rallekralle11/Genna/README.md

# Genna

Work in progress. I believe i can get it working but i won't deal with that right now.

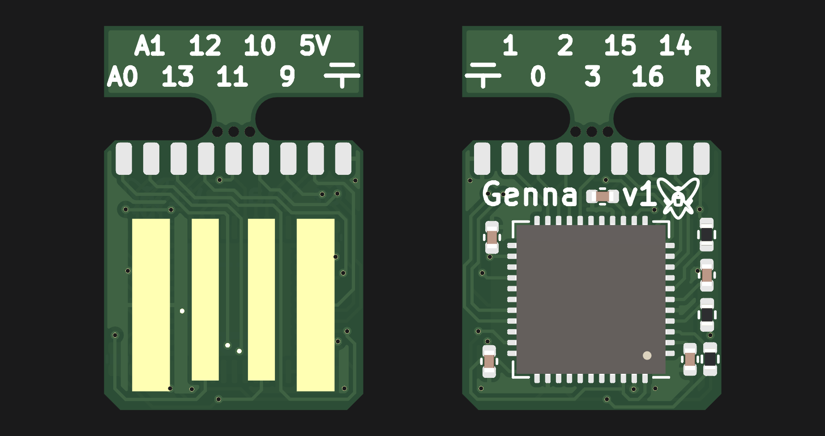
[picture p1: gennaF.png]
board1


Has a snap-off handle so it doesn't get stuck in a port before wires are soldered to it.
All communication pins and a few more are broken out

Licenced under CERN-OHL-P
