rallekralle11/Genna/genna.png

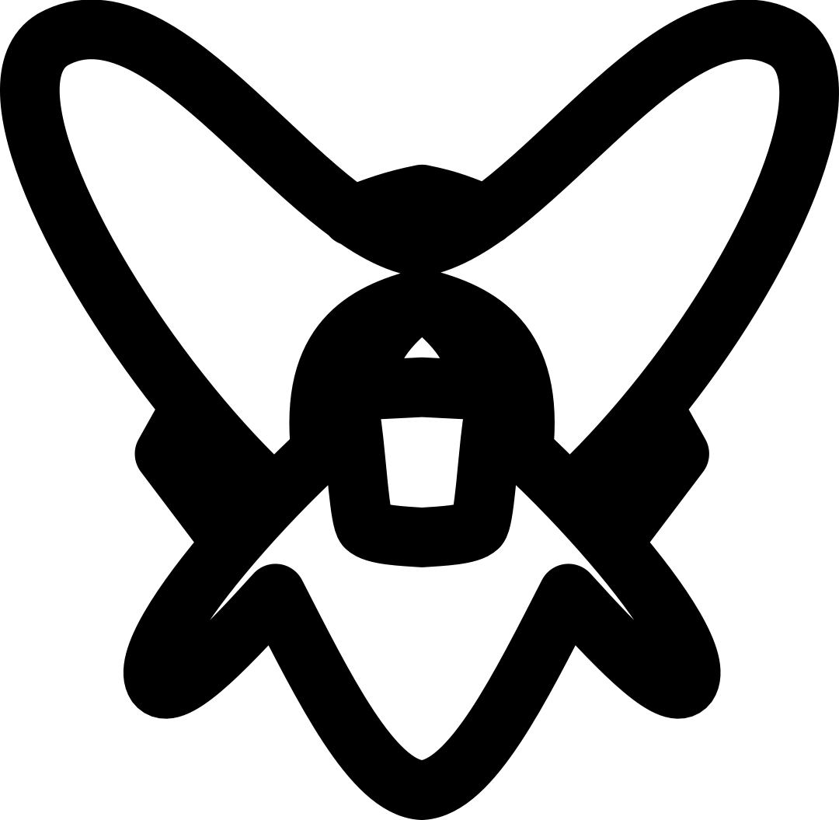
genna.png
