rallekralle11/Genna/gennaB.png

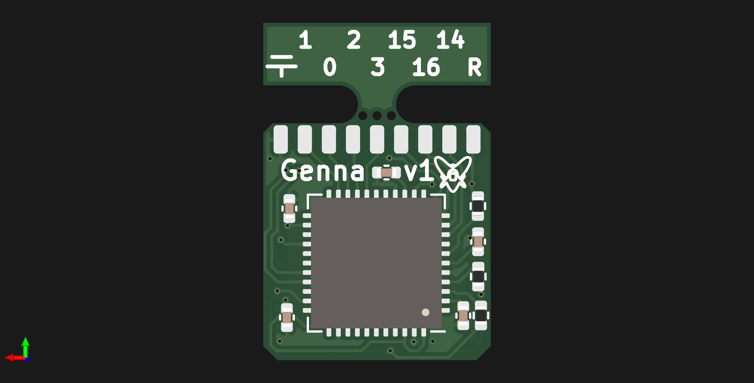
gennaB.png
