rallekralle11/Genna/Genna.kicad_pcb

## KiCad design Genna.kicad_pcb (2022-12-23)

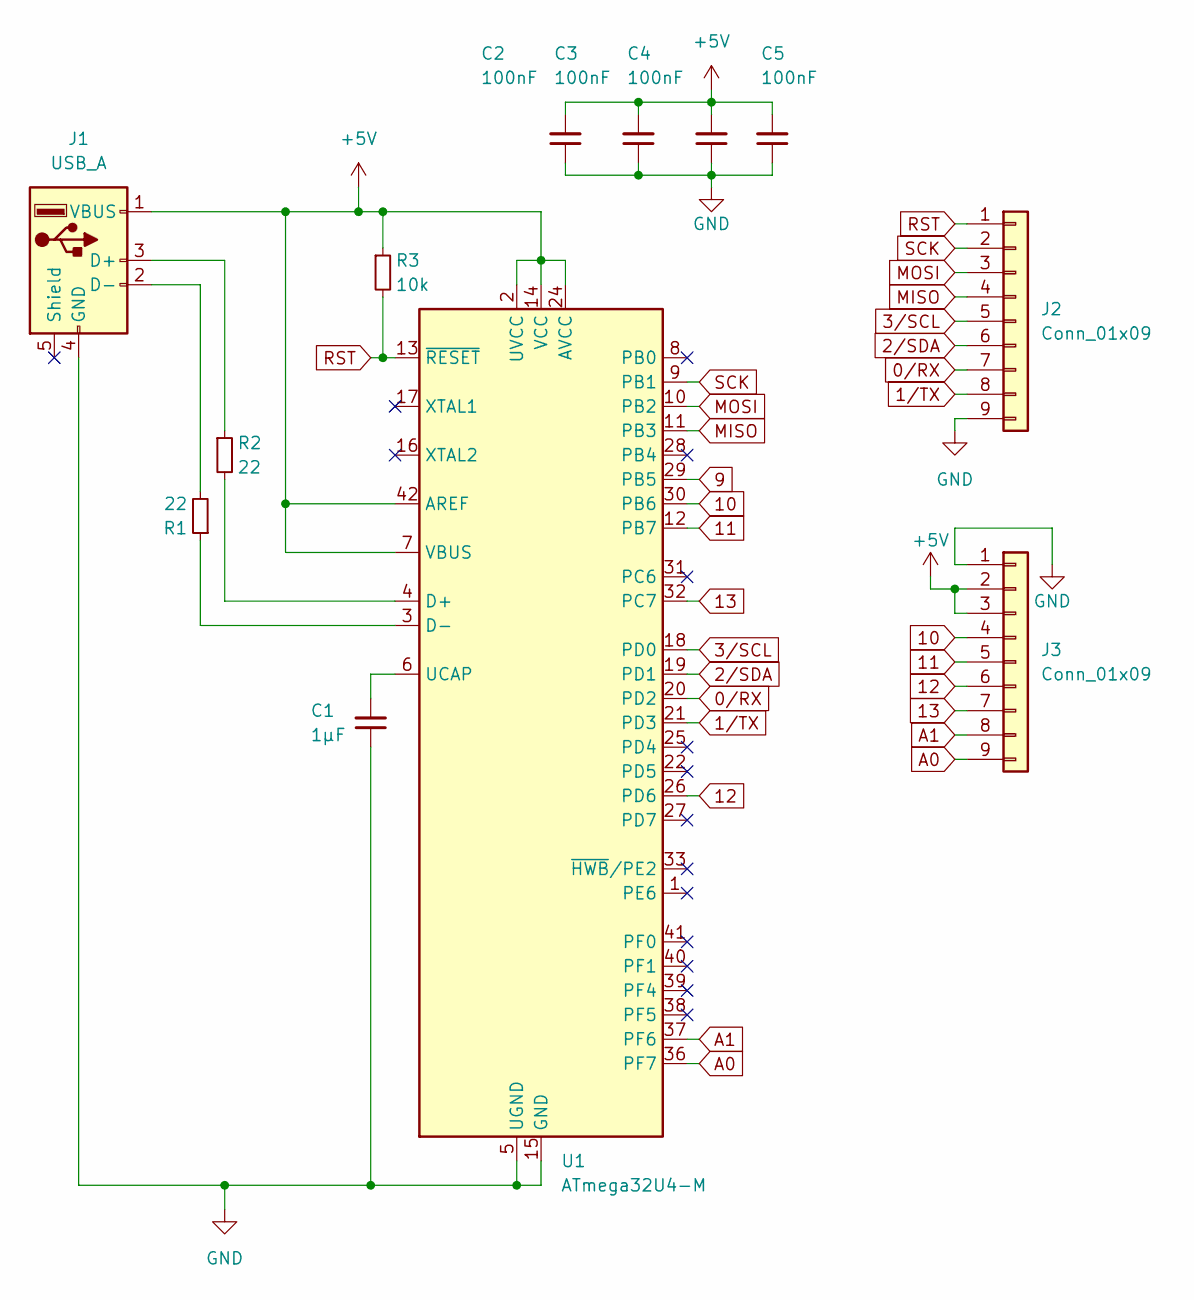
[picture p4: schematic Genna.kicad_sch]

Parts:
C1: 1µF; C_0402_1005Metric
C2, C3, C4, C5: 100nF; C_0402_1005Metric
J1: USB_A; USB_A_PCB_Traces
J2, J3: Conn_01x09; PinHeader_1x09_P1.27mm_Vertical
R1, R2: 22; R_0402_1005Metric
R3: 10k; R_0402_1005Metric
U1: ATmega32U4-M; QFN-44-1EP_7x7mm_P0.5mm_EP5.2x5.2mm

Connections:
0/RX: J2.7, U1.20 (PD2)
1/TX: J2.8, U1.21 (PD3)
2/SDA: J2.6, U1.19 (PD1)
3/SCL: J2.5, U1.18 (PD0)
9: U1.29 (PB5)
10: J3.4, U1.30 (PB6)
11: J3.5, U1.12 (PB7)
12: J3.6, U1.26 (PD6)
13: J3.7, U1.32 (PC7)
+5V: C2.2, C3.2, C4.2, C5.2, J1.1 (VBUS), J3.2, J3.3, R3.1, U1.2 (UVCC), U1.7 (VBUS), U1.14 (VCC), U1.24 (AVCC), U1.34 (VCC), U1.42 (AREF), U1.44 (AVCC)
A0: J3.9, U1.36 (PF7)
A1: J3.8, U1.37 (PF6)
GND: C1.1, C2.1, C3.1, C4.1, C5.1, J1.4 (GND), J2.9, J3.1, U1.5 (UGND), U1.15 (GND), U1.23 (GND), U1.35 (GND), U1.43 (GND), U1.45 (GND)
MISO: J2.4, U1.11 (PB3)
MOSI: J2.3, U1.10 (PB2)
unnamed: C1.2, U1.6 (UCAP)
unnamed: J1.2 (D-), R1.2
unnamed: J1.3 (D+), R2.1
unnamed: R1.1, U1.3 (D-)
unnamed: R2.2, U1.4 (D+)
RST: J2.1, R3.2, U1.13 (~RESET)
SCK: J2.2, U1.9 (PB1)

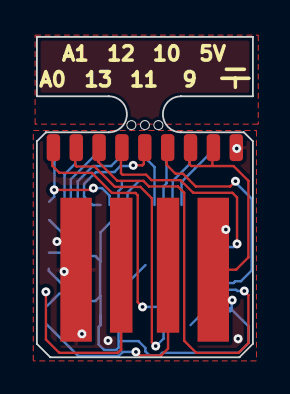
[picture p5: board Genna.kicad_pcb from above]

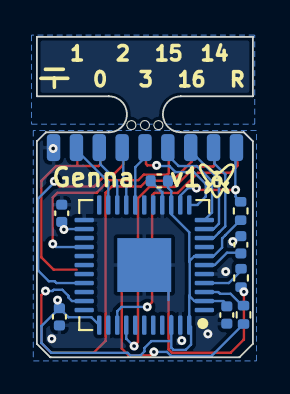
[picture p6: board Genna.kicad_pcb from below]

Board: 2 copper layers, 12.0 x 17.8 mm, 12 parts (10 on the bottom side), 21 nets.
