rallekralle11/Genna/(threads)

Thread 1 (2023-04-27):

Did this fit?

DeadlySurgeon, 2023-04-27:
I figured I would leave this question here. Did you get it ordered, and did it fit well in your socket?

rallekralle11, 2023-04-27:
It did fit nicely and made good contact, but it didn't work anyway. It seems the mega32U4 can't have the arduino bootloader written to it without any external oscillator. I'll probably redesign it sooner or later.

DeadlySurgeon, 2023-04-27:
For my uses that'll probably be fine, but there should be some slim, discrete crystals.

Closed 2023-04-27.
