rallekralle11/Genna/(commit log)

2022-12-19 made gerbers
    [Genna-B_Cu.gbr, Genna-B_Mask.gbr, Genna-B_Paste.gbr, Genna-B_Silkscreen.gbr, Genna-Edge_Cuts.gbr, Genna-F_Cu.gbr, Genna-F_Mask.gbr, Genna-F_Paste.gbr]
2022-12-23 changed via dimensions and had to remove an IO
    [Genna.kicad_pcb, Genna.kicad_sch]
